Kmykh/IoT-Vitalfy/tesis/raices_tls.h

// raices_tls.h — Raíces de Let's Encrypt en las que confía el wearable cuando se conecta al broker de
// producción por TLS (puerto 8883; ver MQTT_BROKER_TLS en secretos.example.h). Son certificados públicos.
//
// El certificado del dominio lo obtiene Caddy en el servidor y se renueva cada ~60 días, pero estas raíces no
// cambian: el firmware no se toca en cada renovación. Hoy la cadena es
//   dominio <- YE2 <- ISRG Root YE <- ISRG Root X2 <- ISRG Root X1
// y valida con cualquiera de las dos raíces. Se confía en ambas por si Let's Encrypt deja de enviar el tramo
// firmado por X1.
//
//   ISRG Root X1  RSA 4096   vence 2035-06-04  SHA-256 96:BC:EC:06:26:49:76:F3:74:60:77:9A:CF:28:C5:A7:
//                                                       CF:E8:A3:C0:AA:E1:1A:8F:FC:EE:05:C0:BD:DF:08:C6
//   ISRG Root X2  ECDSA P-384 vence 2040-09-17 SHA-256 69:72:9B:8E:15:A8:6E:FC:17:7A:57:AF:B7:17:1D:FC:
//                                                       64:AD:D2:8C:2F:CA:8C:F1:50:7E:34:45:3C:CB:14:70
// Origen: https://letsencrypt.org/certs/isrgrootx1.pem y https://letsencrypt.org/certs/isrg-root-x2.pem
#pragma once

// Las dos en un solo PEM terminado en '\0': esp-mqtt (mbedTLS) carga todos los certificados del texto.
static const char RAICES_TLS[] = R"PEM(-----BEGIN CERTIFICATE-----
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
-----END CERTIFICATE-----
-----BEGIN CERTIFICATE-----
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
/q4AaOeMSQ+2b1tbFfLn
-----END CERTIFICATE-----
)PEM";
