Kmykh/IoT-Vitalfy/(commit log)

2026-09-30 chore: agrega .gitignore y las librerías de Arduino del firmware
2026-09-30 feat(firmware): agrega los algoritmos de PPG, ECG y caídas con sus pruebas
2026-09-30 feat(firmware): agrega sensores, pantallas OLED y conectividad MQTT
2026-09-30 docs: agrega el README y la vista previa de las pantallas
2026-10-02 docs: documenta el receptor MQTT del backend y el motor clínico
    El backend ya consume este broker (sesión persistente, QoS 1, telemetría y
    estado) y completa NEWS2/MEWS con observaciones de enfermería para lo que
    el wearable no mide.
2026-10-02 feat(firmware): agrega la sesión de monitoreo, la temperatura predictiva y una sola OLED
    Probado en el ESP32-S3 real:
    - Arranque: no sigue hasta que responden los cuatro sensores y los electrodos del
    ECG están conectados (BOOT sigue igual); después espera al paciente y empieza a
    medir y enviar al poner el dedo. Sin paciente no envía nada (tampoco caídas).
    - Temperatura: solo se informa con la sonda sobre la piel; predice el equilibrio
    ajustando la curva exponencial por mínimos cuadrados y clasifica con las bandas
    de NEWS2.
    - Una sola OLED: alterna los signos y el ECG a pantalla completa con un corazón que
    late con cada QRS.
    - Correcciones del hardware real: rango del ADC del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
2026-10-02 feat(broker): agrega el contenedor monitor para ver los JSON en Docker Desktop
2026-10-02 docs: documenta el arranque, la sesión de monitoreo y la temperatura predictiva
2026-10-09 feat(firmware): agrega el ESP32 DevKit, dos OLED con verificación animada y el LED verde
    Probado en el ESP32 DevKit real:
    - Pines del DevKit (config.h los elige según la placa). La OLED del ECG va en su
    propio bus I2C (SDA = GPIO13, SCL = GPIO14), porque también es 0x3C. No en D12
    (en alto al reiniciar, el ESP32 no arranca) ni en D2 (su LED deja SCL en bajo).
    - Dos OLED otra vez: la principal muestra el chequeo y los signos y nunca el ECG;
    se quita la alternancia de una sola OLED y el ECG a pantalla completa.
    - La OLED del ECG tiene su propia verificación en el arranque: lo que falta, n/6,
    un latido que recorre la pantalla y una barra de progreso.
    - LED verde (GPIO27): encendido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
2026-10-09 docs: documenta las dos pantallas, las conexiones del DevKit y el LED verde
    - Tabla de qué muestra cada OLED y el LED en el arranque, la espera del paciente
    y el monitoreo, con las vistas de pantallas_oled.png (regenerada).
    - Conexiones del ESP32 DevKit: OLED del ECG en D13/D14, LED verde en D27 con su
    resistencia, y por qué no usar D12 ni D2.
    - Problemas frecuentes: OLED del ECG que no responde, LED apagado y arranque
    bloqueado por GPIO12 (boot:0x33).
2026-10-09 feat(firmware): avisa la señal de ECG ruidosa y afina el trazo de la OLED
    Con la señal real del DevKit (electrodos mal pegados) la OLED del ECG dibujaba una
    banda de ruido: 48 % de la energía en 60 Hz y el AD8232 saturado hasta el 51 % del
    tiempo. Esos saltos además se contaban como latidos (fc 140).
    - Calidad de la señal: interferencia de la red (lo que quita el notch) y fracción
    de muestras saturadas, con histéresis (ruidosa sobre 200 conteos RMS o 2 %;
    limpia bajo 140 y 0,5 %). Sin contar el asentamiento de 0,5 s al conectar.
    - Con señal ruidosa el ECG no da FC y la OLED muestra "Señal con ruido" y
    "Fije electrodos" / "Revise el RL" en lugar del ruido; el monitor serie lo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
2026-10-09 docs: documenta el aviso de señal de ECG ruidosa y cómo colocar los electrodos
    - La OLED del ECG: trazo fino y "Señal con ruido" (vista 11b de pantallas_oled.png).
    - Algoritmos: cómo se mide la calidad de la señal y sus umbrales.
    - Problemas frecuentes: "Señal con ruido" y la ubicación de RA, LA y RL.
2026-11-05 feat(broker): permite a cada wearable pedir un QR por el tópico solicitudes
2026-11-05 feat(firmware): mide la FR con el MPU6050 y sigue la vinculación por QR
2026-11-05 feat(firmware): conecta por TLS al broker de producción
2026-11-05 docs: documenta la FR, la vinculación por QR y el broker de producción con TLS
